BYU-ELC/ARC-Timer/README.md

# ARC-Timer
Autonomous Robotics Competition (BYU) Match Timer
