BYU-ELC/ARC-Timer/hardware/IR-Sensor/IR Sensor.brd

## EAGLE design hardware/IR-Sensor/IR Sensor.brd (2023-04-16)

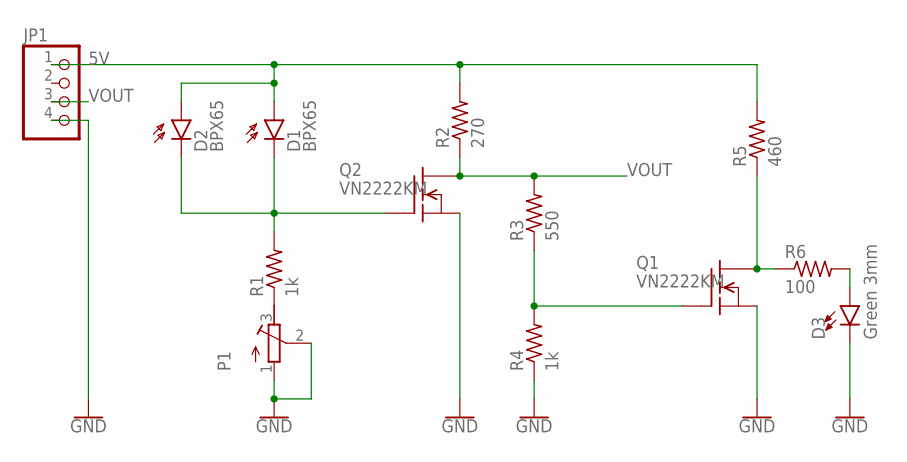
[picture p1: schematic IR Sensor.sch]

Parts:
D1, D2: BPX65
D3: Green 3mm; LED_3MM
JP1: PINHD-1X4; 1X04
P1: R-TRIMM64W; RTRIM64W
Q1, Q2: VN2222KM; TO237
R1, R4: 1k; 0204/7
R2: 270; 0204/7
R3: 550; 0204/7
R5: 460; 0204/7
R6: 100; 0204/7

Connections:
5V: D1.A, D2.A, JP1.1, R2.2, R5.2
GND: D3.K (C), JP1.4, P1.1 (A), P1.2 (S), Q1.3 (S), Q2.3 (S), R4.1
unnamed: P1.3 (E), R1.1
unnamed: D1.K (C), D2.K (C), Q2.2 (G), R1.2
unnamed: Q1.2 (G), R3.1, R4.2
unnamed: D3.A, R6.2
unnamed: Q1.1 (D), R5.1, R6.1
VOUT: JP1.3, Q2.1 (D), R2.1, R3.2

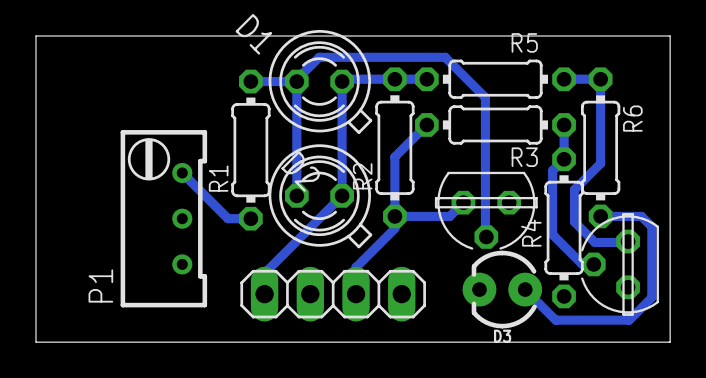
[picture p2: board IR Sensor.brd from above]

Board: 2 copper layers, 35.2 x 17.0 mm, 13 parts (0 on the bottom side), 8 nets.
