BYU-ELC/ARC-Timer/hardware/Clock/Clock_version_2.2.brd

## EAGLE design hardware/Clock/Clock_version_2.2.brd (2023-04-15)

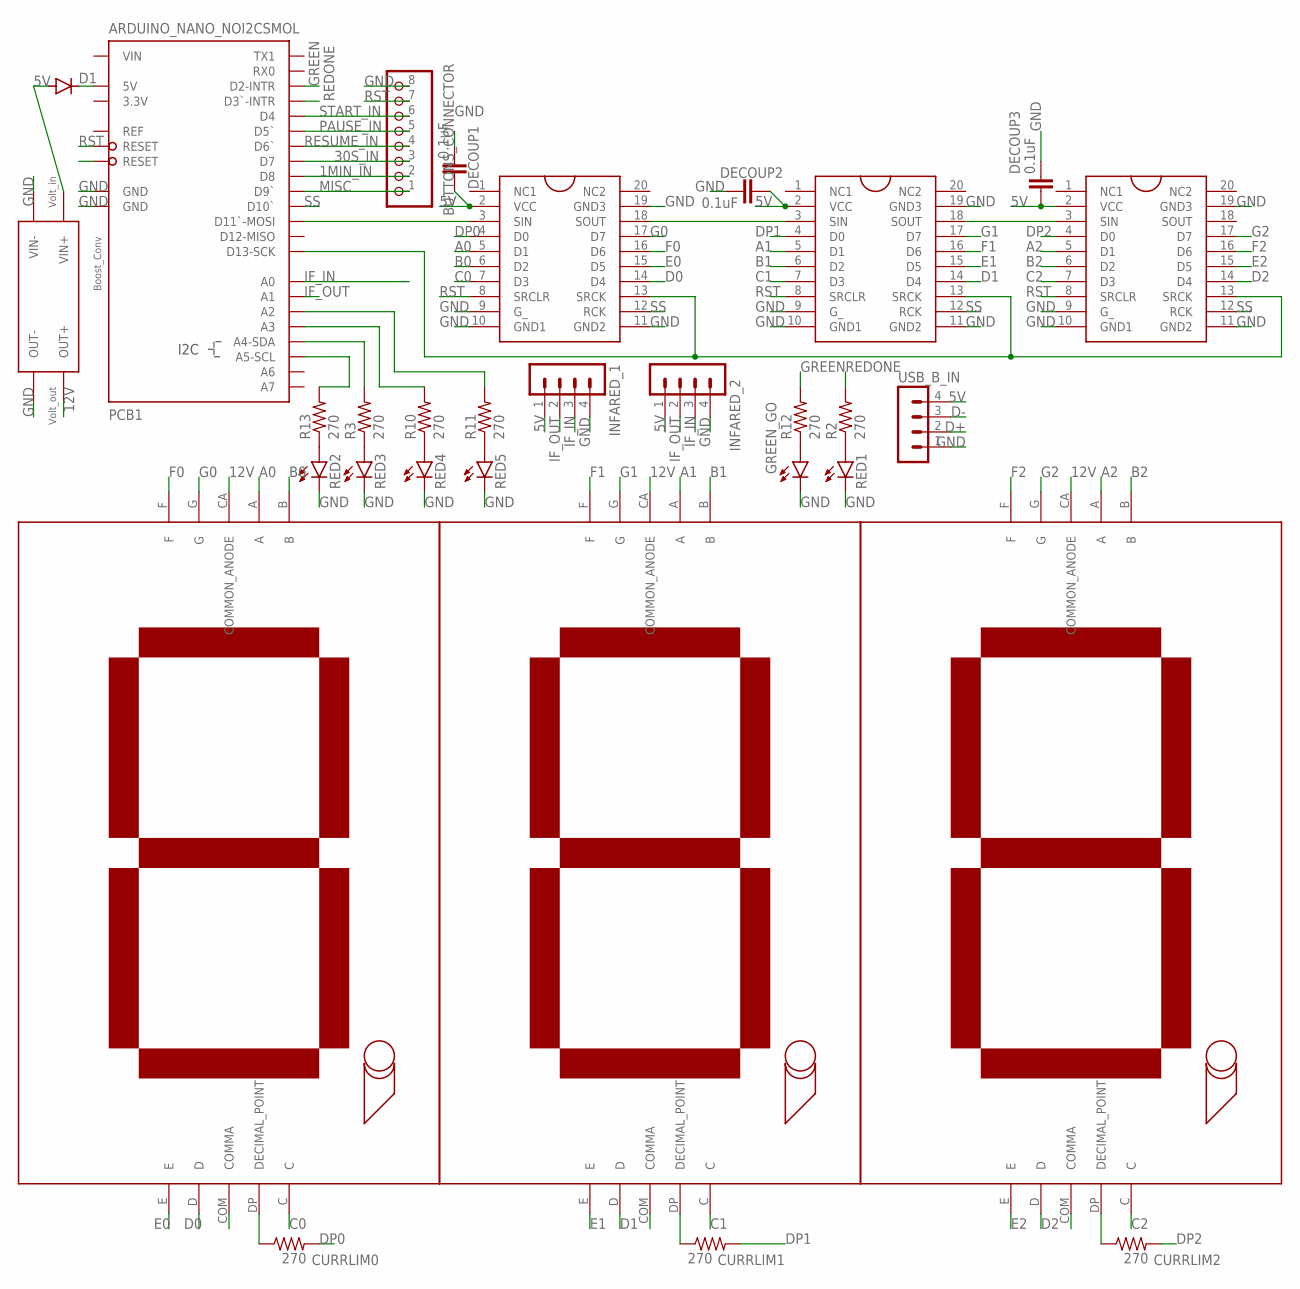
[picture p3: schematic Clock_version_2.2.sch]

Parts:
BUTTONS_CONNECTOR: PINHD-1X8/90; 1X08/90
CURRLIM0, CURRLIM1, CURRLIM2: 270; 0207/10
D1: 1N4148DO35-7; DO35-7
DECOUP1, DECOUP2, DECOUP3: 0.1uF; C2.5-2
GREEN_GO: LED5MM
INFARED_1, INFARED_2: MA04-1
MINUTES: 7SEG_LED_A-3001SR; 7SEG_LED
PCB1: ARDUINO_NANO_NOI2CSMOL; ARDUINO_NANO_SMOL
R2, R3, R10, R11, R12, R13: 270; 0207/10
RED1, RED2, RED3, RED4, RED5: LED5MM
SECONDS_ONES: 7SEG_LED_A-3001SR; 7SEG_LED
SECONDS_TENS: 7SEG_LED_A-3001SR; 7SEG_LED
SP0, SP1, SP2: SHIFT_REGISTER_TPIC6C595; SHIFT_REGISTER
U$4: BOOST_CONV
USB_B_IN: MA04-1

Connections:
1MIN_IN: BUTTONS_CONNECTOR.2, PCB1.D8
5V: D1.A, DECOUP1.2, DECOUP2.2, DECOUP3.2, INFARED_1.1, INFARED_2.1, SP0.2 (VCC), SP1.2 (VCC), SP2.2 (VCC), U$4.P$2 (VIN+), USB_B_IN.4
12V: MINUTES.CA (COMMON_ANODE), SECONDS_ONES.CA (COMMON_ANODE), SECONDS_TENS.CA (COMMON_ANODE), U$4.P$3 (OUT+)
30S_IN: BUTTONS_CONNECTOR.3, PCB1.D7
A0: MINUTES.A, SP0.5 (D1)
A1: SECONDS_TENS.A, SP1.5 (D1)
A2: SECONDS_ONES.A, SP2.5 (D1)
B0: MINUTES.B, SP0.6 (D2)
B1: SECONDS_TENS.B, SP1.6 (D2)
B2: SECONDS_ONES.B, SP2.6 (D2)
C0: MINUTES.C, SP0.7 (D3)
C1: SECONDS_TENS.C, SP1.7 (D3)
C2: SECONDS_ONES.C, SP2.7 (D3)
D0: MINUTES.D, SP0.14 (D4)
D1: SECONDS_TENS.D, SP1.14 (D4)
D2: SECONDS_ONES.D, SP2.14 (D4)
D+: USB_B_IN.2
D-: USB_B_IN.3
DP0: CURRLIM0.2, SP0.4 (D0)
DP1: CURRLIM1.2, SP1.4 (D0)
DP2: CURRLIM2.2, SP2.4 (D0)
E0: MINUTES.E, SP0.15 (D5)
E1: SECONDS_TENS.E, SP1.15 (D5)
E2: SECONDS_ONES.E, SP2.15 (D5)
F0: MINUTES.F, SP0.16 (D6)
F1: SECONDS_TENS.F, SP1.16 (D6)
F2: SECONDS_ONES.F, SP2.16 (D6)
G0: MINUTES.G, SP0.17 (D7)
G1: SECONDS_TENS.G, SP1.17 (D7)
G2: SECONDS_ONES.G, SP2.17 (D7)
GND: BUTTONS_CONNECTOR.8, DECOUP1.1, DECOUP2.1, DECOUP3.1, GREEN_GO.K (C), INFARED_1.4, INFARED_2.4, PCB1.GND, PCB1.GND@2 (GND), RED1.K (C), RED2.K (C), RED3.K (C), RED4.K (C), RED5.K (C), SP0.9 (G_), SP0.10 (GND1), SP0.11 (GND2), SP0.19 (GND3), SP1.9 (G_), SP1.10 (GND1), SP1.11 (GND2), SP1.19 (GND3), SP2.9 (G_), SP2.10 (GND1), SP2.11 (GND2), SP2.19 (GND3), U$4.P$1 (VIN-), U$4.P$4 (OUT-), USB_B_IN.1
GREEN: PCB1.D2 (D2-INTR), R12.2
IF_IN: INFARED_1.3, INFARED_2.3, PCB1.A0
IF_OUT: INFARED_1.2, INFARED_2.2, PCB1.A1
MISC: BUTTONS_CONNECTOR.1, PCB1.D9 (D9`)
unnamed: PCB1.D11 (D11`-MOSI), SP0.3 (SIN)
unnamed: D1.C, PCB1.5V
unnamed: CURRLIM0.1, MINUTES.DP (DECIMAL_POINT)
unnamed: CURRLIM1.1, SECONDS_TENS.DP (DECIMAL_POINT)
unnamed: CURRLIM2.1, SECONDS_ONES.DP (DECIMAL_POINT)
unnamed: SP0.18 (SOUT), SP1.3 (SIN)
unnamed: SP1.18 (SOUT), SP2.3 (SIN)
unnamed: PCB1.D13 (D13-SCK), SP0.13 (SRCK), SP1.13 (SRCK), SP2.13 (SRCK)
unnamed: R2.1, RED1.A
unnamed: R13.1, RED2.A
unnamed: R3.1, RED3.A
unnamed: R10.1, RED4.A
unnamed: R11.1, RED5.A
unnamed: GREEN_GO.A, R12.1
unnamed: PCB1.A5 (A5-SCL), R13.2
unnamed: PCB1.A4 (A4-SDA), R3.2
unnamed: PCB1.A3, R10.2
unnamed: PCB1.A2, R11.2
PAUSE_IN: BUTTONS_CONNECTOR.5, PCB1.D5 (D5`)
REDONE: PCB1.D3 (D3`-INTR), R2.2
RESUME_IN: BUTTONS_CONNECTOR.4, PCB1.D6 (D6`)
RST: BUTTONS_CONNECTOR.7, PCB1.RESET, SP0.8 (SRCLR), SP1.8 (SRCLR), SP2.8 (SRCLR)
SS: PCB1.D10 (D10`), SP0.12 (RCK), SP1.12 (RCK), SP2.12 (RCK)
START_IN: BUTTONS_CONNECTOR.6, PCB1.D4

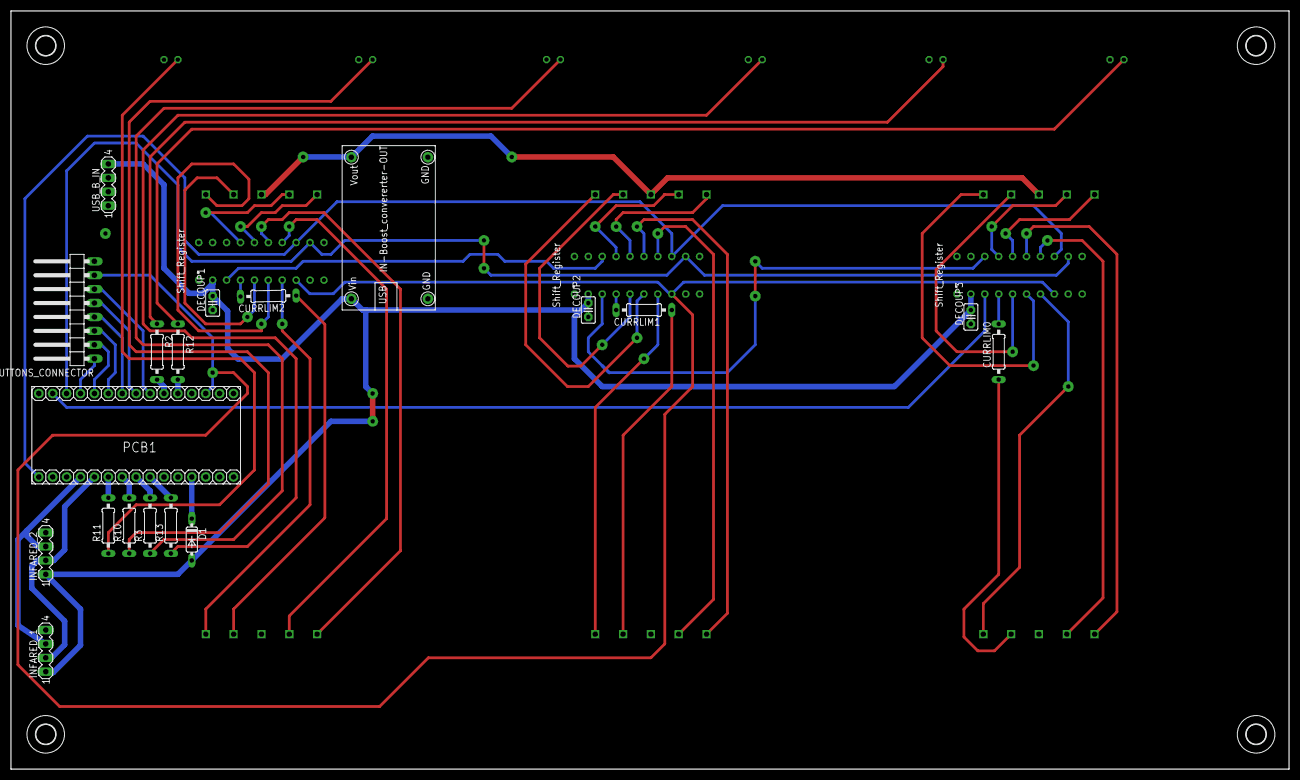
[picture p4: board Clock_version_2.2.brd from above]

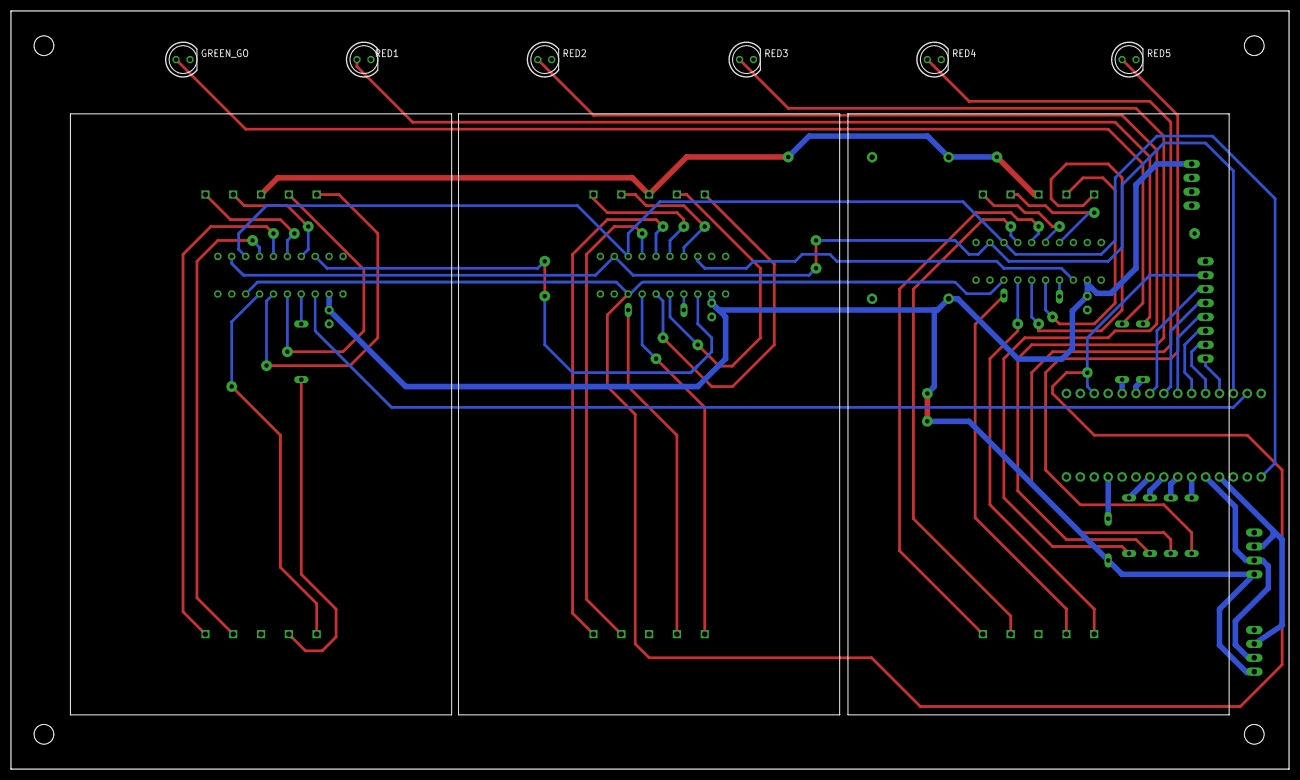
[picture p5: board Clock_version_2.2.brd from below]

Board: 2 copper layers, 233.3 x 138.4 mm, 35 parts (9 on the bottom side), 57 nets.

Other parts of the board:
U$1, U$6, U$7, U$8: 3,6
