BYU-ELC/ARC-Timer/hardware/ButtonBoard/ButtonBoard.brd

## EAGLE design hardware/ButtonBoard/ButtonBoard.brd (2023-04-11)

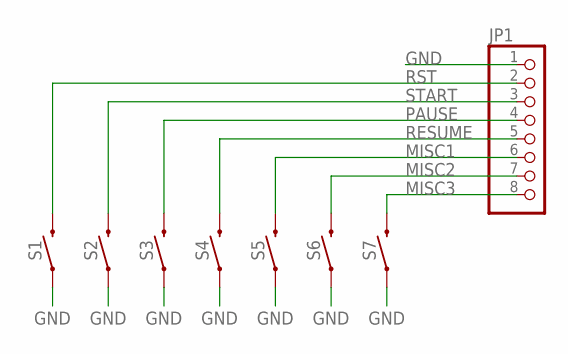
[picture p6: schematic ButtonBoard.sch]

Parts:
JP1: PINHD-1X8/90; 1X08/90
S1, S2, S3, S4, S5, S6, S7: MOMENTARY-SWITCH-SPST-SMD-12MM; TACTILE_SWITCH_SMD_12MM

Connections:
GND: JP1.1, S1.1, S2.1, S3.1, S4.1, S5.1, S6.1, S7.1
MISC1: JP1.6, S5.3 (2)
MISC2: JP1.7, S6.3 (2)
MISC3: JP1.8, S7.3 (2)
PAUSE: JP1.4, S3.3 (2)
RESUME: JP1.5, S4.3 (2)
RST: JP1.2, S1.3 (2)
START: JP1.3, S2.3 (2)

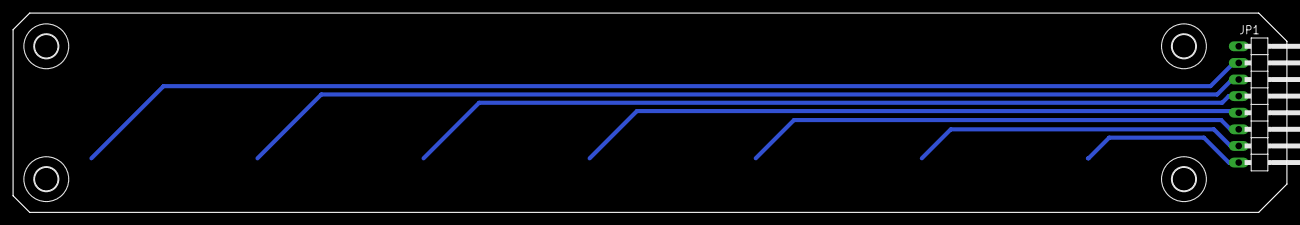
[picture p7: board ButtonBoard.brd from above]

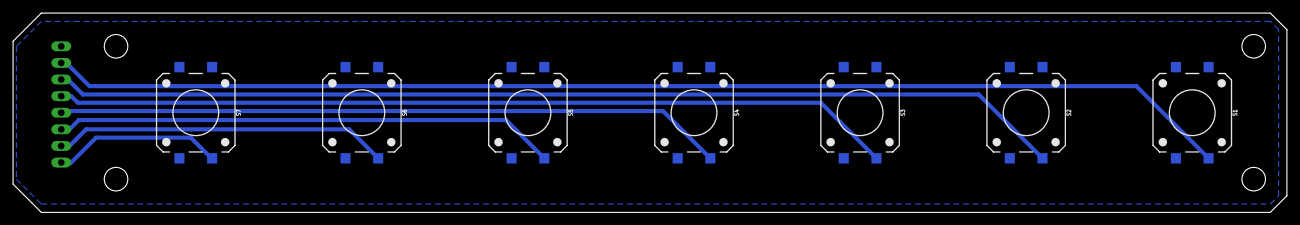
[picture p8: board ButtonBoard.brd from below]

Board: 2 copper layers, 194.8 x 30.5 mm, 12 parts (7 on the bottom side), 8 nets.

Other parts of the board:
U$1, U$2, U$3, U$5: 3,6
