BYU-ELC/ARC-Timer/firmware/display.cpp

// Author: Ben Broce (BYU ECEn ELC)

#include "display.h"
#include "pinDefs.h"
#include <SPI.h>
#include <stdint.h>

// 7-segment control bytes for decimal digits
// ex: SEG_DIGIT[0] gives byte to write to shift register to display "0"
const uint8_t displayDigit[10] = {
    0x7E, // "0" - 01111110
    0x0C, // "1" - 00001100
    0xB6, // "2" - 10110110
    0x9E, // "3" - 10011110
    0xCC, // "4" - 11001100
    0xDA, // "5" - 11011010
    0xFA, // "6" - 11111010
    0x0E, // "7" - 00001110
    0xFE, // "8" - 11111110
    0xDE  // "9" - 11011110
};

SPISettings tpic6b595(DISPLAY_SHIFTREG_MAX_RATE, MSBFIRST, SPI_MODE0);

// initialize the display hardware (call before writes)
void displayInit() {
  // init SPI hardware, setup for output
  SPI.begin();
  pinMode(SHIFTREG_RCK_PIN, OUTPUT);
  // release register values -> 7-seg output
  digitalWrite(SHIFTREG_RCK_PIN, HIGH);
  // clear display
  displayClear();
}

// write bytes to each display's shift register
void displayWriteBytes(uint8_t left, uint8_t middle, uint8_t right) {
  // prepare SPI hardware for a transaction
  // (set max data rate, MSB first, and
  // SPI_MODE1: clock idles low, bit write on rising clk)
  SPI.beginTransaction(tpic6b595);

  // hold 7-seg output while writing data
  digitalWrite(SHIFTREG_RCK_PIN, LOW);

  // write bytes in order: left, middle, right digit
  SPI.transfer(right);
  SPI.transfer(middle);
  SPI.transfer(left);

  // release reg values -> 7-seg to display new values
  digitalWrite(SHIFTREG_RCK_PIN, HIGH);

  // release SPI hardware after transaction
  SPI.endTransaction();
}

// write a time to the display in the format "M.SS"
void displayWriteTime(uint8_t min, uint8_t tenSec, uint8_t oneSec) {
  displayWriteBytes((displayDigit[min] | DISPLAY_DIGIT_DP_MASK),
                    displayDigit[tenSec], displayDigit[oneSec]);
}

// write a time to the display given the time in MS
void displayWriteTimeMS(uint32_t timeMS) {
  // 1000 ms per second
  uint16_t seconds = timeMS / 1000;
  // 60 seconds per minute (seconds -> remainder seconds)
  uint8_t minutes = seconds / 60;
  seconds = seconds % 60;
  // 10 seconds per tenSecond (seconds -> remainder seconds)
  uint8_t tenSeconds = seconds / 10;
  seconds = seconds % 10;

  displayWriteTime(minutes, tenSeconds, seconds);
}

// turn off all display segments
void displayClear() {
  displayWriteBytes(DISPLAY_DIGIT_CLR_MASK, DISPLAY_DIGIT_CLR_MASK,
                    DISPLAY_DIGIT_CLR_MASK);
}
