BYU-ELC/ARC-Timer/(commit log)

2023-02-16 Setup Arduino project
2023-02-16 Add timerDisplay module
2023-02-16 include stdint.h in timerDisplay.cpp
2023-02-17 refactor timerDisplay -> display, clarify RCK
2023-02-17 add prototype for timerControl module
2023-02-28 Add buttons file, pin defs, and timer state action
2023-03-07 Fix initial problems and begin testing
    [display.cpp, display.h, pinDefs.h]
2023-03-14 Fix bug in display driver (working now)
    [display.cpp, display.h]
2023-03-14 Add buttons module and document
2023-03-14 fix one shot bug
    [buttons.cpp]
2023-03-16 add leds module
2023-03-16 add button test, fix formatting
    [buttons.h, tests.h, timerControl.cpp, timerControl.h]
2023-03-16 change misc button to sub 15 sec button
2023-03-16 Write timer control SM
2023-03-16 Setup main file for timer control loop
2023-03-16 fix minor bugs for prototype
    [display.cpp, pinDefs.h, timerControl.cpp]
2023-03-28 Add button board
    [ButtonBoard.brd, ButtonBoard.sch]
2023-03-28 Add custom button board library
2023-03-28 organize clock files into directory
    [Clock_rev1.brd, Clock_rev1.sch]
2023-04-04 increase mounting hole size
    [ButtonBoard.brd]
2023-04-11 Update pinout and display write order for PCB
2023-04-16 Add IR sensor hardware eagle files (from Ben D)
    [IR Sensor.brd, IR Sensor.sch]
2023-04-16 Clean up clock files (remove old revision, misplaced copies)
    [Clock_rev1.brd, Clock_rev1.sch, Clock_version_2.2.brd, Clock_version_2.2.sch]
2023-04-16 moved IR BoM to top level IR hardware dir
2023-04-17 Change infrared input to pullup to prevent float
    [infrared.cpp]
